AdrianPietrzak1998/FalconEye_ControlBoard_F1/PCB/Power_supply.kicad_sch

## KiCad design PCB/Power_supply.kicad_sch (2023-07-17)

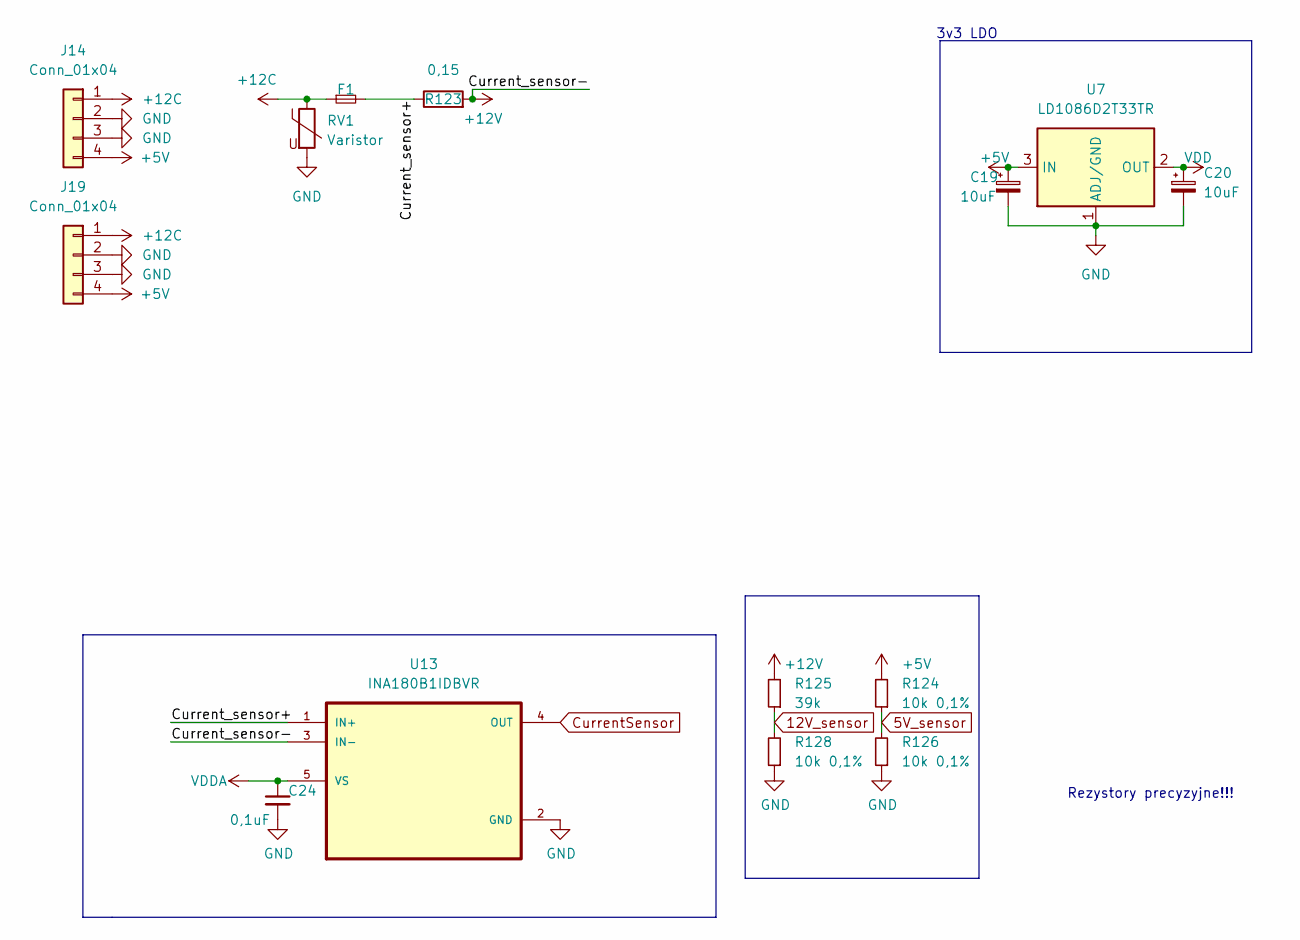
[picture p1: schematic Power_supply.kicad_sch]

Parts:
C19, C20: 10uF; C_0603_1608Metric; LCSC C19702
C24: 0,1uF; C_0603_1608Metric; LCSC C14663
F1: Fuse_Small; Fuseholder_Littelfuse_100_series_5x20mm
J14, J19: Conn_01x04; Molex_KK-254_AE-6410-04A_1x04_P2.54mm_Vertical
R123: 0,15; R_2512_6332Metric; LCSC C335237
R124, R126, R128: 10k 0,1%; R_0603_1608Metric; LCSC C374378
R125: 39k; R_0603_1608Metric; LCSC C23153
RV1: Varistor; RV_Disc_D7mm_W3.4mm_P5mm
U7: LD1086D2T33TR; TO-263-2; LCSC C7915
U13: INA180B1IDBVR; SOT95P280X145-5N; LCSC C122882

Connections:
5V_sensor: R124.1, R126.2
12V_sensor: R125.1, R128.2
+5V: C19.1, J14.4, J19.4, R124.2, U7.3 (IN)
+12C: F1.1, J14.1, J19.1, RV1.1
+12V: R123.2, R125.2, U13.3 (IN-)
CurrentSensor: U13.4 (OUT)
Current_sensor+: F1.2, R123.1, U13.1 (IN+)
GND: C19.2, C20.2, C24.2, J14.2, J14.3, J19.2, J19.3, R126.1, R128.1, RV1.2, U7.1 (ADJ/GND), U13.2 (GND)
VDD: C20.1, U7.2 (OUT)
VDDA: C24.1, U13.5 (VS)

Notes on the sheet:
3v3 LDO
Rezystory precyzyjne!!!
