AdrianPietrzak1998/FalconEye_ControlBoard_F1/PCB/USB_hub.kicad_sch

## KiCad design PCB/USB_hub.kicad_sch (2023-07-17)

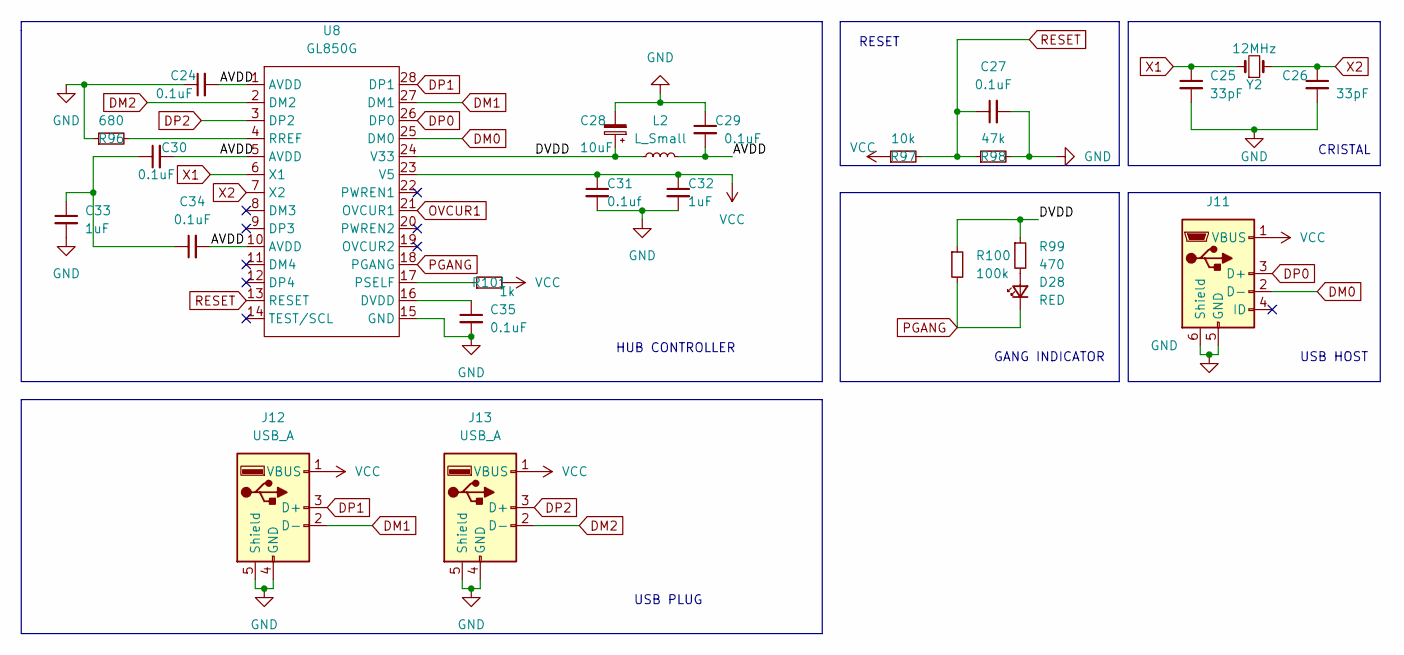
[picture p2: schematic USB_hub.kicad_sch]

Parts:
C24, C27, C29, C30, C34, C35: 0.1uF; C_0603_1608Metric
C25, C26: 33pF; C_0603_1608Metric
C28: 10uF; CP_Elec_4x4.5
C31: 0.1uf; C_0603_1608Metric
C32, C33: 1uF; C_0603_1608Metric
D28: RED; LED_0805_2012Metric
J11: USB_B_Mini; USB_Mini-B_Lumberg_2486_01_Horizontal
J12, J13: USB_A; USB_A_Stewart_SS-52100-001_Horizontal
L2: L_Small; L_0603_1608Metric
R96: 680; R_0603_1608Metric
R97: 10k; R_0603_1608Metric
R98: 47k; R_0603_1608Metric
R99: 470; R_0603_1608Metric
R100: 100k; R_0603_1608Metric
R101: 1k; R_0603_1608Metric
U8: GL850G; SSOP-28_3.9x9.9mm_P0.635mm
Y2: 12MHz; Crystal_SMD_3225-4Pin_3.2x2.5mm

Connections:
AVDD: C24.2, C29.2, C30.2, C34.2, L2.2, U8.1 (AVDD), U8.5 (AVDD), U8.10 (AVDD)
DM0: J11.2 (D-), U8.25 (DM0)
DM1: J12.2 (D-), U8.27 (DM1)
DM2: J13.2 (D-), U8.2 (DM2)
DP0: J11.3 (D+), U8.26 (DP0)
DP1: J12.3 (D+), U8.28 (DP1)
DP2: J13.3 (D+), U8.3 (DP2)
DVDD: C28.1, L2.1, R99.1, R100.1, U8.24 (V33)
GND: C24.1, C25.2, C26.2, C27.2, C28.2, C29.1, C31.2, C32.2, C33.2, C35.2, J11.5 (GND), J11.6 (Shield), J12.4 (GND), J12.5 (Shield), J13.4 (GND), J13.5 (Shield), R96.1, R98.2, U8.15 (GND)
unnamed: C30.1, C33.1, C34.1
unnamed: C35.1, U8.16 (DVDD)
unnamed: D28.2 (A), R99.2
unnamed: R96.2, U8.4 (RREF)
unnamed: R101.1, U8.17 (PSELF)
OVCUR1: U8.21 (OVCUR1)
PGANG: D28.1 (K), R100.2, U8.18 (PGANG)
RESET: C27.1, R97.2, R98.1, U8.13 (RESET)
VCC: C31.1, C32.1, J11.1 (VBUS), J12.1 (VBUS), J13.1 (VBUS), R97.1, R101.2, U8.23 (V5)
X1: C25.1, U8.6 (X1), Y2.1
X2: C26.1, U8.7 (X2), Y2.2

Notes on the sheet:
USB HOST
GANG INDICATOR
CRISTAL
RESET
USB PLUG
HUB CONTROLLER
