AdrianPietrzak1998/FalconEye_ControlBoard_F1/PCB/stm32_prototyp.kicad_sch

## KiCad design PCB/stm32_prototyp.kicad_sch (2023-07-17)

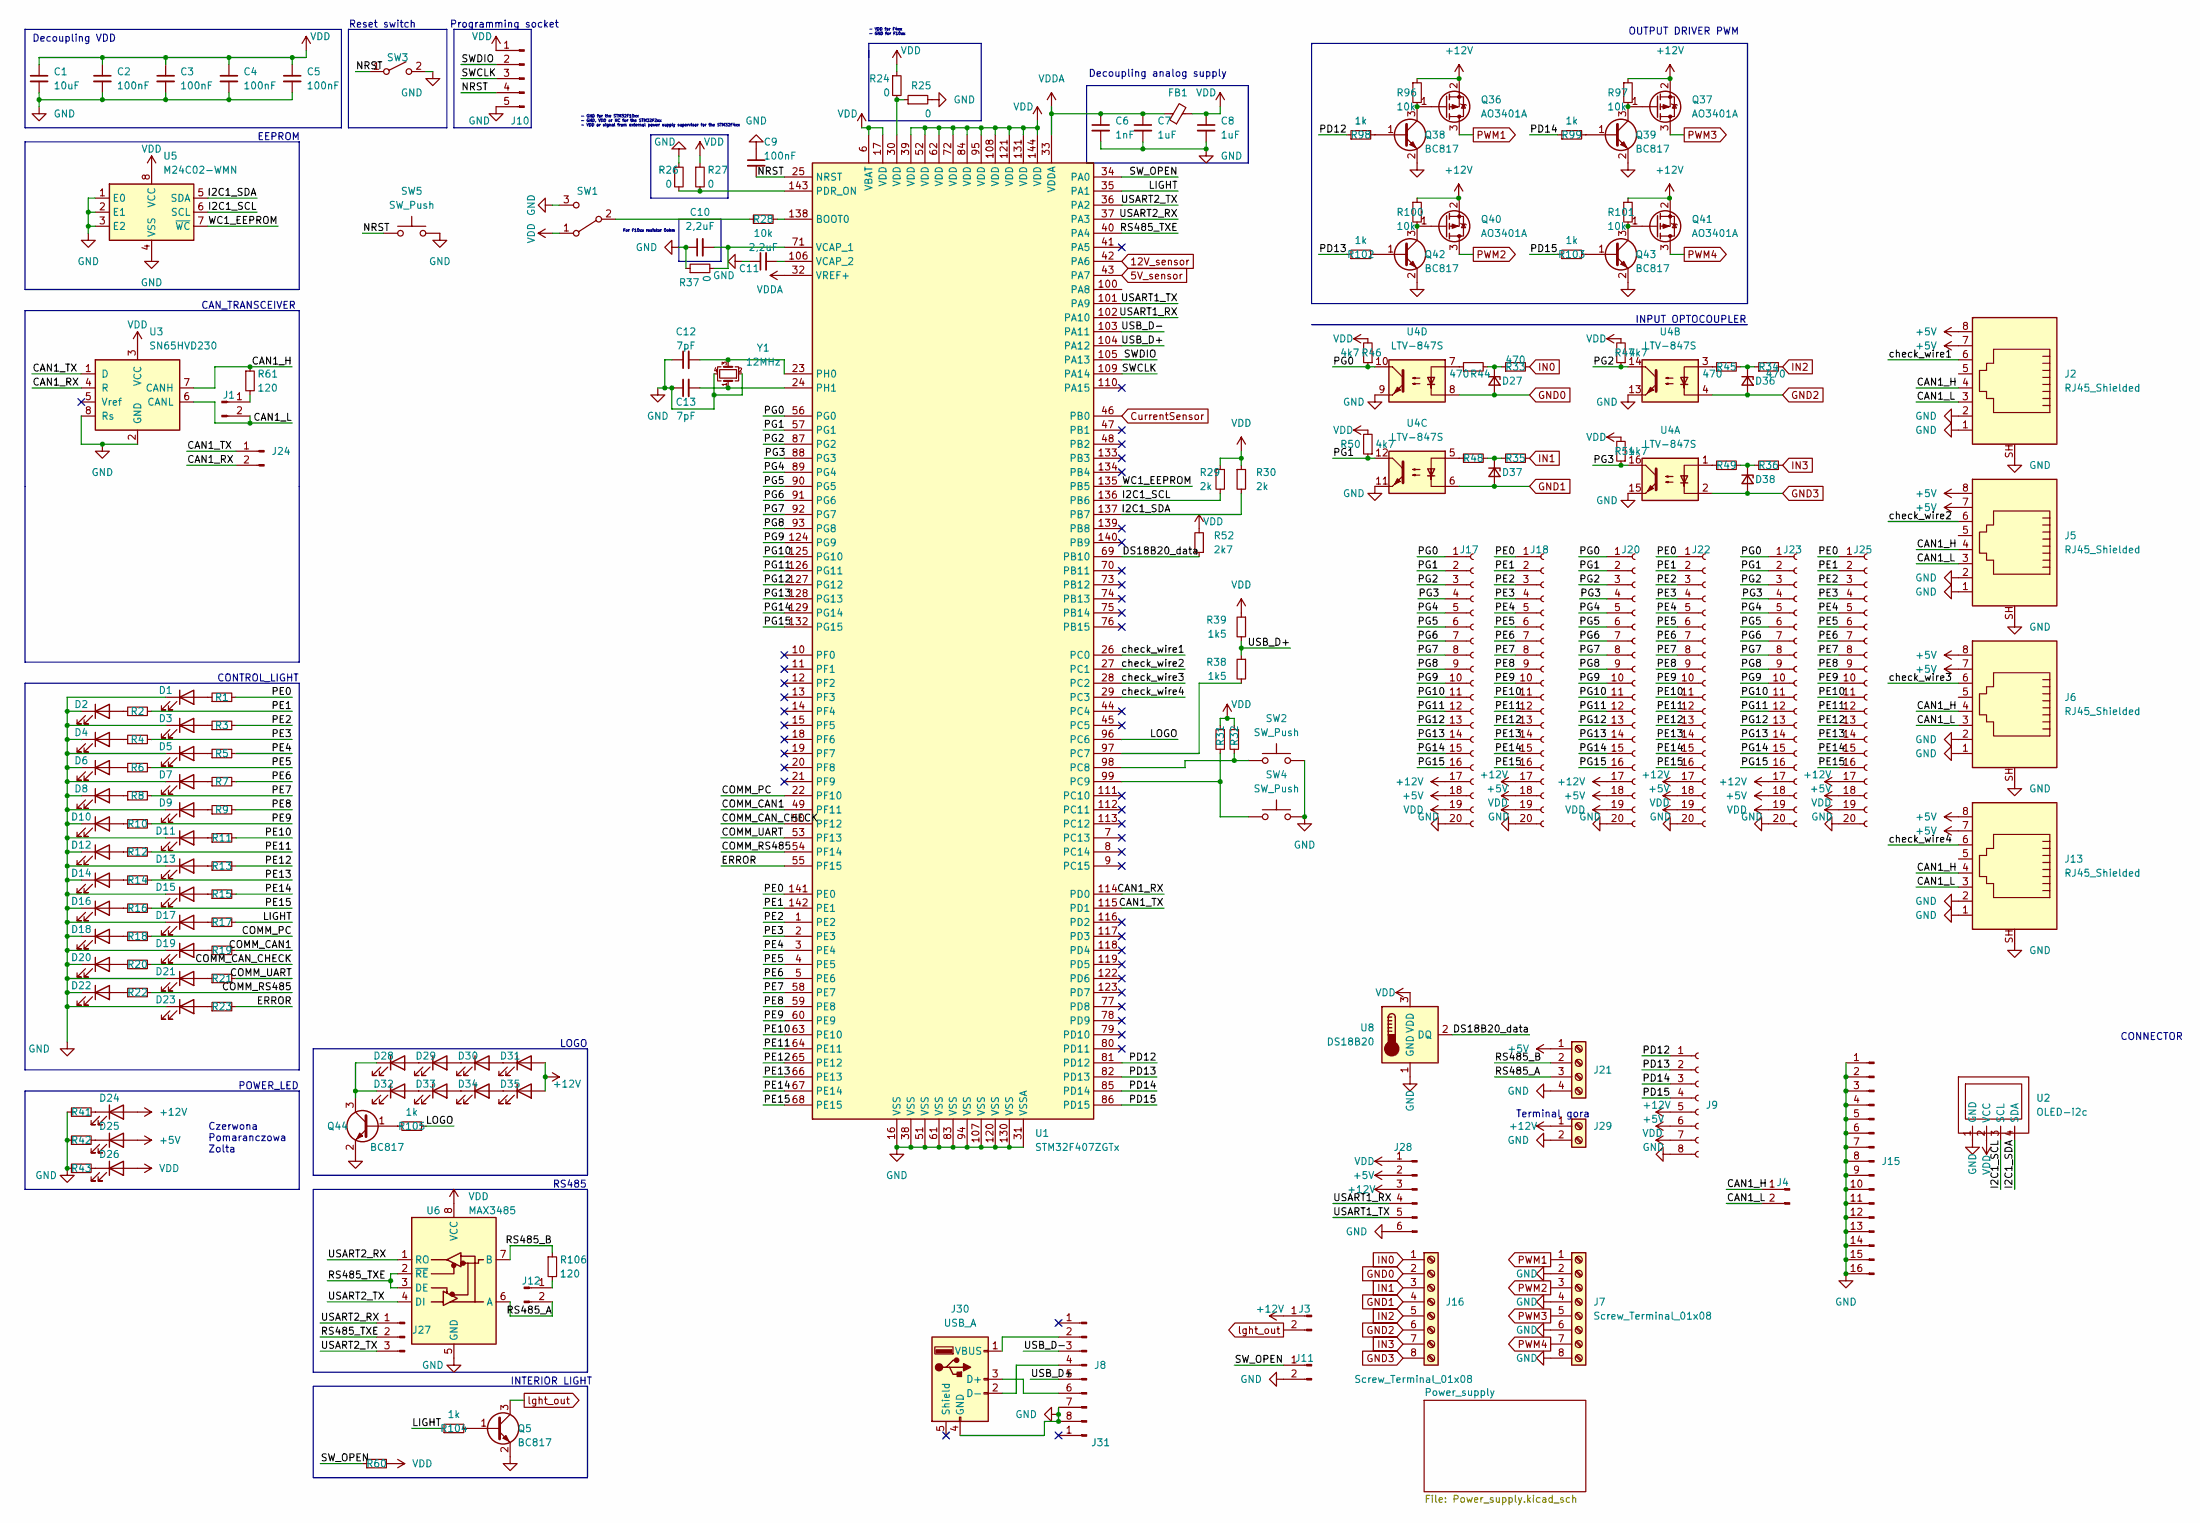
[picture p3: schematic stm32_prototyp.kicad_sch]

Parts:
C1: 10uF; C_1206_3216Metric; LCSC C13585
C2, C3, C4, C5, C9: 100nF; C_0603_1608Metric; LCSC C14663
C6: 1nF; C_0603_1608Metric; LCSC C1588
C7, C8: 1uF; C_0603_1608Metric; LCSC C15849
C10, C11: 2,2uF; C_0603_1608Metric; LCSC C23630
C12, C13: 7pF; C_0402_1005Metric; LCSC C260628
D1, D2, D3, D4, D5, D6, D7, D8, D9, D10, D11, D12, D13, D14, D15, D16, D18: Blue; LED_0603_1608Metric; LCSC C118339
D17: Green; LED_0603_1608Metric; LCSC C131282
D19, D23, D24: Red; LED_0603_1608Metric; LCSC C128052
D20, D25: Orange; LED_0603_1608Metric; LCSC C264452
D21, D22, D26: Yellow; LED_0603_1608Metric; LCSC C90109
D27, D36, D37, D38: D_Zener_Small; D_SOD-123; LCSC C86234
D28, D29, D30, D31, D32, D33, D34, D35: Green; LED_D5.0mm_Clear
FB1: FerriteBead_Small; L_0603_1608Metric; LCSC C76892
J1, J3, J4, J11, J12, J24: Conn_01x02_Male; PinHeader_1x02_P2.54mm_Vertical
J2, J5, J6, J13: RJ45_Shielded; RJ45_Molex_0855135013_Vertical; DigiKey 0855135013
J7, J16: Screw_Terminal_01x08; Altech_AK300_1x08_P5.00mm_45-Degree
J8: Conn_01x08_Male; PinHeader_2x04_P2.54mm_Vertical
J9: Conn_01x08_Female; PinHeader_2x04_P2.54mm_Vertical
J10: Conn_01x05_Male; PinHeader_1x05_P2.54mm_Vertical
J15: Conn_01x16_Male; PinHeader_2x08_P2.54mm_Vertical
J17, J18, J20, J22, J23, J25: Conn_01x20_Female; PinSocket_2x10_P2.54mm_Vertical
J21: Screw_Terminal_01x04; Altech_AK300_1x04_P5.00mm_45-Degree
J27: Conn_01x03_Male; PinHeader_1x03_P2.54mm_Vertical
J28: Conn_01x06_Male; IDC-Header_2x03_P2.54mm_Vertical
J29: Screw_Terminal_01x02; Altech_AK300_1x02_P5.00mm_45-Degree
J30: USB_A; USB_A_Molex_105057_Vertical
J31: Conn_01x01_Male; PinHeader_1x01_P2.54mm_Vertical
Q5, Q38, Q39, Q42, Q43, Q44: BC817; SOT-23; LCSC C475629
Q36, Q37, Q40, Q41: AO3401A; SOT-23; LCSC C15127
R1, R2, R3, R4, R5, R6, R7, R8, R9, R10, R11, R12, R13, R14, R15, R16, R18, R19, R20, R21, R22, R23: 100; R_0603_1608Metric; LCSC C22775
R17: 20; R_0603_1608Metric; LCSC C22950
R24, R25, R26, R27, R37: 0; R_0603_1608Metric; LCSC C21189
R28, R96, R97, R100, R101: 10k; R_0603_1608Metric; LCSC C25804
R29, R30: 2k; R_0603_1608Metric; LCSC C22975
R31, R32, R46, R47, R50, R51, R60: 4k7; R_0603_1608Metric; LCSC C23162
R33, R34, R35, R36, R41, R44, R45, R48, R49: 470; R_0603_1608Metric; LCSC C23179
R38, R39: 1k5; R_0603_1608Metric
R42: 150; R_0603_1608Metric; LCSC C22808
R43: 680; R_0603_1608Metric; LCSC C23228
R52: 2k7; R_0603_1608Metric; LCSC C13167
R61, R106: 120; R_0603_1608Metric; LCSC C22787
R98, R99, R102, R103, R104, R105: 1k; R_0603_1608Metric; LCSC C21190
SW1: SW_SPDT; PinHeader_1x03_P2.54mm_Vertical
SW2, SW4, SW5: SW_Push; SW_PUSH_6mm
SW3: SW_SPST; PinHeader_1x02_P2.54mm_Vertical
U1: STM32F407ZGTx; LQFP-144_20x20mm_P0.5mm
U2: OLED-i2c; 128x64OLED
U3: SN65HVD230; SOIC-8_3.9x4.9mm_P1.27mm; LCSC C12084
U4: LTV-847S; SMDIP-16_W9.53mm; LCSC C114599
U5: M24C02-WMN; SOIC-8_3.9x4.9mm_P1.27mm; LCSC C7562
U6: MAX3485; SOIC-8_3.9x4.9mm_P1.27mm; LCSC C668204
U8: DS18B20; TO-92_Inline; LCSC C9753
Y1: 12MHz; Crystal_SMD_7050-4Pin_7.0x5.0mm; LCSC C254255

Connections:
5V_sensor: U1.43 (PA7)
12V_sensor: U1.42 (PA6)
+5V: D25.2 (A), J2.7, J2.8, J5.7, J5.8, J6.7, J6.8, J9.6, J13.7, J13.8, J17.18, J18.18, J20.18, J21.1, J22.18, J23.18, J25.18, J28.2
+12V: D24.2 (A), D31.2 (A), D35.2 (A), J3.1, J9.5, J17.17, J18.17, J20.17, J22.17, J23.17, J25.17, J28.3, J29.1, Q36.2 (S), Q37.2 (S), Q40.2 (S), Q41.2 (S), R96.1, R97.1, R100.1, R101.1
CAN1_H: J2.4, J4.1, J5.4, J6.4, J13.4, R61.1, U3.7 (CANH)
CAN1_L: J1.2, J2.3, J4.2, J5.3, J6.3, J13.3, U3.6 (CANL)
CAN1_RX: J24.2, U1.114 (PD0), U3.4 (R)
CAN1_TX: J24.1, U1.115 (PD1), U3.1 (D)
COMM_CAN1: R19.2, U1.49 (PF11)
COMM_CAN_CHECK: R20.2, U1.50 (PF12)
COMM_PC: R18.2, U1.22 (PF10)
COMM_RS485: R22.2, U1.54 (PF14)
COMM_UART: R21.2, U1.53 (PF13)
CurrentSensor: U1.46 (PB0)
DS18B20_data: R52.1, U1.69 (PB10), U8.2 (DQ)
ERROR: R23.2, U1.55 (PF15)
GND: C1.2, C2.2, C3.2, C4.2, C5.2, C6.2, C7.2, C8.2, C9.1, C10.1, C11.1, C12.1, C13.1, D1.1 (K), D2.1 (K), D3.1 (K), D4.1 (K), D5.1 (K), D6.1 (K), D7.1 (K), D8.1 (K), D9.1 (K), D10.1 (K), D11.1 (K), D12.1 (K), D13.1 (K), D14.1 (K), D15.1 (K), D16.1 (K), D17.1 (K), D18.1 (K), D19.1 (K), D20.1 (K), D21.1 (K), D22.1 (K), D23.1 (K), J2.1, J2.2, J2.SH, J5.1, J5.2, J5.SH, J6.1, J6.2, J6.SH, J7.2, J7.4, J7.6, J7.8, J8.7, J8.8, J9.8, J10.5, J11.2, J13.1, J13.2, J13.SH, J15.1, J15.2, J15.3, J15.4, J15.5, J15.6, J15.7, J15.8, J15.9, J15.10, J15.11, J15.12, J15.13, J15.14, J15.15, J15.16, J17.20, J18.20, J20.20, J21.4, J22.20, J23.20, J25.20, J28.6, J29.2, J30.4 (GND), Q5.2 (E), Q38.2 (E), Q39.2 (E), Q42.2 (E), Q43.2 (E), Q44.2 (E), R25.2, R26.1, R37.1, R41.1, R42.1, R43.1, SW1.3 (C), SW2.1, SW3.2 (B), SW4.1, SW5.1, U1.16 (VSS), U1.31 (VSSA), U1.38 (VSS), U1.51 (VSS), U1.61 (VSS), U1.83 (VSS), U1.94 (VSS), U1.107 (VSS), U1.120 (VSS), U1.130 (VSS), U2.1 (GND), U3.2 (GND), U3.8 (Rs), U4.9, U4.11, U4.13, U4.15, U5.1 (E0), U5.2 (E1), U5.3 (E2), U5.4 (VSS), U6.5 (GND), U8.1 (GND), Y1.2, Y1.4
GND0: D27.2 (A), J16.2, U4.8
GND1: D37.2 (A), J16.4, U4.6
GND2: D36.2 (A), J16.6, U4.4
GND3: D38.2 (A), J16.8, U4.2
I2C1_SCL: R29.2, U1.136 (PB6), U2.3 (SCL), U5.6 (SCL)
I2C1_SDA: R30.2, U1.137 (PB7), U2.4 (SDA), U5.5 (SDA)
IN0: J16.1, R33.2
IN1: J16.3, R35.2
IN2: J16.5, R34.2
IN3: J16.7, R36.2
LIGHT: R17.2, R104.1, U1.35 (PA1)
LOGO: R105.1, U1.96 (PC6)
NRST: C9.2, J10.4, SW3.1 (A), SW5.2, U1.25 (NRST)
unnamed: C10.2, R37.2, U1.71 (VCAP_1)
unnamed: C11.2, U1.106 (VCAP_2)
unnamed: C12.2, U1.23 (PH0), Y1.3
unnamed: C13.2, U1.24 (PH1), Y1.1
unnamed: D1.2 (A), R1.1
unnamed: D2.2 (A), R2.1
unnamed: D3.2 (A), R3.1
unnamed: D4.2 (A), R4.1
unnamed: D5.2 (A), R5.1
unnamed: D6.2 (A), R6.1
unnamed: D7.2 (A), R7.1
unnamed: D8.2 (A), R8.1
unnamed: D9.2 (A), R9.1
unnamed: D10.2 (A), R10.1
unnamed: D11.2 (A), R11.1
unnamed: D12.2 (A), R12.1
unnamed: D13.2 (A), R13.1
unnamed: D14.2 (A), R14.1
unnamed: D15.2 (A), R15.1
unnamed: D16.2 (A), R16.1
unnamed: D17.2 (A), R17.1
unnamed: D18.2 (A), R18.1
unnamed: D19.2 (A), R19.1
unnamed: D20.2 (A), R20.1
unnamed: D21.2 (A), R21.1
unnamed: D22.2 (A), R22.1
unnamed: D23.2 (A), R23.1
unnamed: D24.1 (K), R41.2
unnamed: D25.1 (K), R42.2
unnamed: D26.1 (K), R43.2
unnamed: D27.1 (K), R33.1, R44.2
unnamed: D28.1 (K), D32.1 (K), Q44.3 (C)
unnamed: D28.2 (A), D29.1 (K)
unnamed: D29.2 (A), D30.1 (K)
unnamed: D30.2 (A), D31.1 (K)
unnamed: D32.2 (A), D33.1 (K)
unnamed: D33.2 (A), D34.1 (K)
unnamed: D34.2 (A), D35.1 (K)
unnamed: D36.1 (K), R34.1, R45.2
unnamed: D37.1 (K), R35.1, R48.2
unnamed: D38.1 (K), R36.1, R49.2
unnamed: J1.1, R61.2
unnamed: J12.1, R106.2
unnamed: J8.2, J30.1 (VBUS)
unnamed: J8.4, J30.2 (D-)
unnamed: J8.6, J30.3 (D+)
unnamed: Q5.1 (B), R104.2
unnamed: Q36.1 (G), Q38.3 (C), R96.2
unnamed: Q37.1 (G), Q39.3 (C), R97.2
unnamed: Q38.1 (B), R98.2
unnamed: Q39.1 (B), R99.2
unnamed: Q40.1 (G), Q42.3 (C), R100.2
unnamed: Q41.1 (G), Q43.3 (C), R101.2
unnamed: Q42.1 (B), R102.2
unnamed: Q43.1 (B), R103.2
unnamed: Q44.1 (B), R105.2
unnamed: R24.2, R25.1, U1.30 (VDD)
unnamed: R26.2, R27.2, U1.143 (PDR_ON)
unnamed: R28.1, SW1.2 (B)
unnamed: R28.2, U1.138 (BOOT0)
unnamed: R31.2, SW4.2, U1.99 (PC9)
unnamed: R32.2, SW2.2, U1.98 (PC8)
unnamed: R38.2, U1.97 (PC7)
unnamed: R44.1, U4.7
unnamed: R45.1, U4.3
unnamed: R48.1, U4.5
unnamed: R49.1, U4.1
PD12: J9.1, R98.1, U1.81 (PD12)
PD13: J9.2, R102.1, U1.82 (PD13)
PD14: J9.3, R99.1, U1.85 (PD14)
PD15: J9.4, R103.1, U1.86 (PD15)
PE0: J18.1, J22.1, J25.1, R1.2, U1.141 (PE0)
PE1: J18.2, J22.2, J25.2, R2.2, U1.142 (PE1)
PE2: J18.3, J22.3, J25.3, R3.2, U1.1 (PE2)
PE3: J18.4, J22.4, J25.4, R4.2, U1.2 (PE3)
PE4: J18.5, J22.5, J25.5, R5.2, U1.3 (PE4)
PE5: J18.6, J22.6, J25.6, R6.2, U1.4 (PE5)
PE6: J18.7, J22.7, J25.7, R7.2, U1.5 (PE6)
PE7: J18.8, J22.8, J25.8, R8.2, U1.58 (PE7)
PE8: J18.9, J22.9, J25.9, R9.2, U1.59 (PE8)
PE9: J18.10, J22.10, J25.10, R10.2, U1.60 (PE9)
PE10: J18.11, J22.11, J25.11, R11.2, U1.63 (PE10)
PE11: J18.12, J22.12, J25.12, R12.2, U1.64 (PE11)
PE12: J18.13, J22.13, J25.13, R13.2, U1.65 (PE12)
PE13: J18.14, J22.14, J25.14, R14.2, U1.66 (PE13)
PE14: J18.15, J22.15, J25.15, R15.2, U1.67 (PE14)
PE15: J18.16, J22.16, J25.16, R16.2, U1.68 (PE15)
PG0: J17.1, J20.1, J23.1, R46.1, U1.56 (PG0), U4.10
PG1: J17.2, J20.2, J23.2, R50.1, U1.57 (PG1), U4.12
PG2: J17.3, J20.3, J23.3, R47.1, U1.87 (PG2), U4.14
PG3: J17.4, J20.4, J23.4, R51.1, U1.88 (PG3), U4.16
PG4: J17.5, J20.5, J23.5, U1.89 (PG4)
PG5: J17.6, J20.6, J23.6, U1.90 (PG5)
PG6: J17.7, J20.7, J23.7, U1.91 (PG6)
PG7: J17.8, J20.8, J23.8, U1.92 (PG7)
PG8: J17.9, J20.9, J23.9, U1.93 (PG8)
PG9: J17.10, J20.10, J23.10, U1.124 (PG9)
PG10: J17.11, J20.11, J23.11, U1.125 (PG10)
PG11: J17.12, J20.12, J23.12, U1.126 (PG11)
PG12: J17.13, J20.13, J23.13, U1.127 (PG12)
PG13: J17.14, J20.14, J23.14, U1.128 (PG13)
PG14: J17.15, J20.15, J23.15, U1.129 (PG14)
PG15: J17.16, J20.16, J23.16, U1.132 (PG15)
PWM1: J7.1, Q36.3 (D)
PWM2: J7.3, Q40.3 (D)
PWM3: J7.5, Q37.3 (D)
PWM4: J7.7, Q41.3 (D)
RS485_A: J12.2, J21.3, U6.6 (A)
RS485_B: J21.2, R106.1, U6.7 (B)
RS485_TXE: J27.2, U1.40 (PA4), U6.2 (~RE), U6.3 (DE)
SWCLK: J10.3, U1.109 (PA14)
SWDIO: J10.2, U1.105 (PA13)
SW_OPEN: J11.1, R60.1, U1.34 (PA0)
USART1_RX: J28.4, U1.102 (PA10)
USART1_TX: J28.5, U1.101 (PA9)
USART2_RX: J27.1, U1.37 (PA3), U6.1 (RO)
USART2_TX: J27.3, U1.36 (PA2), U6.4 (DI)
USB_D+: J8.5, R38.1, R39.2, U1.104 (PA12)
USB_D-: J8.3, U1.103 (PA11)
VDD: C1.1, C2.1, C3.1, C4.1, C5.1, C8.1, D26.2 (A), FB1.2, J9.7, J10.1, J17.19, J18.19, J20.19, J22.19, J23.19, J25.19, J28.1, R24.1, R27.1, R29.1, R30.1, R31.1, R32.1, R39.1, R46.2, R47.2, R50.2, R51.2, R52.2, R60.2, SW1.1 (A), U1.6 (VBAT), U1.17 (VDD), U1.39 (VDD), U1.52 (VDD), U1.62 (VDD), U1.72 (VDD), U1.84 (VDD), U1.95 (VDD), U1.108 (VDD), U1.121 (VDD), U1.131 (VDD), U1.144 (VDD), U2.2 (VCC), U3.3 (VCC), U5.8 (VCC), U6.8 (VCC), U8.3 (VDD)
VDDA: C6.1, C7.1, FB1.1, U1.32 (VREF+), U1.33 (VDDA)
WC1_EEPROM: U1.135 (PB5), U5.7 (~WC)
check_wire1: J2.6, U1.26 (PC0)
check_wire2: J5.6, U1.27 (PC1)
check_wire3: J6.6, U1.28 (PC2)
check_wire4: J13.6, U1.29 (PC3)
lght_out: J3.2, Q5.3 (C)

Notes on the sheet:
Terminal gora
EEPROM
Decoupling VDD
Reset switch
INPUT OPTOCOUPLER
- GND for the STM32F10xx - GND, VDD or NC for the STM32F2xx - VDD or signal from external power supply supervisor for the STM32F4xx
CONNECTOR
CONTROL_LIGHT
INTERIOR LIGHT
Programming socket
Decoupling analog supply
LOGO
POWER_LED
Czerwona Pomaranczowa Zolta
For F10xx resistor 0ohm
CAN_TRANSCEIVER
- VDD for F4xx - GND for F10xx
OUTPUT DRIVER PWM
RS485
