AdrianPietrzak1998/FalconEye_ControlBoard_F1/FalconEye ControlBoard.ioc

Mcu.UserName=STM32F103ZETx
PA0-WKUP.GPIO_Label=SW_OPEN
PA0-WKUP.Signal=GPIO_Input
PA1.Signal=S_TIM5_CH2
PA10.Signal=USART1_RX
PA11.Signal=USB_DM
PA12.Signal=USB_DP
PA13.Signal=SYS_JTMS-SWDIO
PA14.Signal=SYS_JTCK-SWCLK
PA2.Signal=USART2_TX
PA3.Signal=USART2_RX
PA4.GPIO_Label=RS485_TXE
PA4.Signal=GPIO_Output
PA6.Signal=ADCx_IN6
PA7.Signal=ADCx_IN7
PA9.Signal=USART1_TX
PB0.Signal=ADCx_IN8
PB10.Signal=USART3_TX
PB5.GPIO_Label=WC_EEPROM
PB5.Signal=GPIO_Output
PB6.Signal=I2C1_SCL
PB7.Signal=I2C1_SDA
PC0.GPIO_Label=CHECK_WIRE_1
PC0.Signal=GPIO_Input
PC1.GPIO_Label=CHECK_WIRE_2
PC1.Signal=GPIO_Input
PC2.GPIO_Label=CHECK_WIRE_3
PC2.Signal=GPIO_Input
PC3.GPIO_Label=CHECK_WIRE_4
PC3.Signal=GPIO_Input
PC6.Signal=S_TIM3_CH1
PC8.GPIO_Label=BUTTON_DOWN
PC8.Signal=GPIO_Input
PC9.GPIO_Label=BUTTON_UP
PC9.Signal=GPIO_Input
PD12.Signal=S_TIM4_CH1
PD13.Signal=S_TIM4_CH2
PD14.Signal=S_TIM4_CH3
PD15.Signal=S_TIM4_CH4
PE0.Signal=GPIO_Output
PE1.Signal=GPIO_Output
PE10.Signal=GPIO_Output
PE11.Signal=GPIO_Output
PE12.Signal=GPIO_Output
PE13.Signal=GPIO_Output
PE14.Signal=GPIO_Output
PE15.Signal=GPIO_Output
PE2.Signal=GPIO_Output
PE3.Signal=GPIO_Output
PE4.Signal=GPIO_Output
PE5.Signal=GPIO_Output
PE6.Signal=GPIO_Output
PE7.Signal=GPIO_Output
PE8.Signal=GPIO_Output
PE9.Signal=GPIO_Output
PF10.GPIO_Label=COMM_PC_LED
PF10.Signal=GPIO_Output
PF11.GPIO_Label=COMM_CAN_LED
PF11.Signal=GPIO_Output
PF12.GPIO_Label=COMM_CAN_CHECK_LED
PF12.Signal=GPIO_Output
PF13.GPIO_Label=COMM_UART_LED
PF13.Signal=GPIO_Output
PF14.GPIO_Label=COMM_RS485_LED
PF14.Signal=GPIO_Output
PF15.GPIO_Label=ERROR_LED
PF15.Signal=GPIO_Output
PF2.Signal=GPIO_Input
PG0.Signal=GPIO_Input
PG1.Signal=GPIO_Input
PG10.Signal=GPIO_Input
PG11.Signal=GPIO_Input
PG12.Signal=GPIO_Input
PG13.Signal=GPIO_Input
PG14.Signal=GPIO_Input
PG15.Signal=GPIO_Input
PG2.Signal=GPIO_Input
PG3.Signal=GPIO_Input
PG4.Signal=GPIO_Input
PG5.Signal=GPIO_Input
PG6.Signal=GPIO_Input
PG7.Signal=GPIO_Input
PG8.Signal=GPIO_Input
PG9.Signal=GPIO_Input
