AdrianPietrzak1998/FalconEye_ControlBoard_F1/Core/Inc/main.h

#define __LOGO_LED_GET __HAL_TIM_GET_COMPARE(&htim3, TIM_CHANNEL_1)
#define __LIGHT_LED_GET __HAL_TIM_GET_COMPARE(&htim5, TIM_CHANNEL_2)
#define COMM_PC_LED_Pin GPIO_PIN_10
#define COMM_PC_LED_GPIO_Port GPIOF
#define CHECK_WIRE_1_Pin GPIO_PIN_0
#define CHECK_WIRE_1_GPIO_Port GPIOC
#define CHECK_WIRE_2_Pin GPIO_PIN_1
#define CHECK_WIRE_2_GPIO_Port GPIOC
#define CHECK_WIRE_3_Pin GPIO_PIN_2
#define CHECK_WIRE_3_GPIO_Port GPIOC
#define CHECK_WIRE_4_Pin GPIO_PIN_3
#define CHECK_WIRE_4_GPIO_Port GPIOC
#define SW_OPEN_Pin GPIO_PIN_0
#define SW_OPEN_GPIO_Port GPIOA
#define RS485_TXE_Pin GPIO_PIN_4
#define RS485_TXE_GPIO_Port GPIOA
#define COMM_CAN_LED_Pin GPIO_PIN_11
#define COMM_CAN_LED_GPIO_Port GPIOF
#define COMM_CAN_CHECK_LED_Pin GPIO_PIN_12
#define COMM_CAN_CHECK_LED_GPIO_Port GPIOF
#define COMM_UART_LED_Pin GPIO_PIN_13
#define COMM_UART_LED_GPIO_Port GPIOF
#define COMM_RS485_LED_Pin GPIO_PIN_14
#define COMM_RS485_LED_GPIO_Port GPIOF
#define ERROR_LED_Pin GPIO_PIN_15
#define ERROR_LED_GPIO_Port GPIOF
#define BUTTON_DOWN_Pin GPIO_PIN_8
#define BUTTON_DOWN_GPIO_Port GPIOC
#define BUTTON_UP_Pin GPIO_PIN_9
#define BUTTON_UP_GPIO_Port GPIOC
#define WC_EEPROM_Pin GPIO_PIN_5
#define WC_EEPROM_GPIO_Port GPIOB
#define ERROR_DS ErrorCode.DsError = 1
#define ERROR_OLED ErrorCode.OledError = 1
#define ERROR_EEPROM ErrorCode.EepromError = 1
