AdrianPietrzak1998/FalconEye_ControlBoard_F1/Core/Src/M24Cxx.c

/*
 * M24Cxx.c
 *
 *  Created on: Jun 15, 2023
 *      Author: Adrian
 */
#include "M24Cxx.h"
#include "main.h"



void m24cxxInit(m24cxx_t *m24, I2C_HandleTypeDef *i2c, uint8_t addr, uint16_t memsize, GPIO_TypeDef *WcPort, uint16_t WcPin)
{
	m24 -> addr    = addr<<1;
	m24 -> i2c     = i2c;
	m24 -> memsize = memsize;
	m24 -> WcPort  = WcPort;
	m24 -> WcPin   = WcPin;
	HAL_GPIO_WritePin(m24->WcPort, m24->WcPin, SET);
}

HAL_StatusTypeDef m24cxxRead8Bit(m24cxx_t *m24, uint8_t DataAddr, uint8_t *Data)
{
	int32_t i = 0;
	while((m24->i2c)->hdmarx->State != HAL_DMA_STATE_READY && i<=200000)
	{
		i++;
	}
	if((m24->i2c)->hdmarx->State == HAL_DMA_STATE_READY)
	{
	HAL_I2C_Mem_Read_DMA(m24 ->i2c, m24 -> addr, DataAddr, 1, Data, 1);
	return HAL_OK;
	}
	else
	{
		ERROR_EEPROM;
		return HAL_ERROR;
	}
}

void m24cxxRead8BitWoDma(m24cxx_t *m24, uint8_t DataAddr, uint8_t *Data)
{
	HAL_I2C_Mem_Read(m24 ->i2c, m24 -> addr, DataAddr, 1, Data, 1, 500);
}

HAL_StatusTypeDef m24cxxWrite8Bit(m24cxx_t *m24, uint8_t DataAddr, uint8_t *Data)
{
	HAL_GPIO_WritePin(m24->WcPort, m24->WcPin, RESET);
	m24 -> WcIsZero = 1;
	int32_t i = 0;
	while((m24->i2c)->hdmatx->State != HAL_DMA_STATE_READY && i<=200000)
	{
		i++;
	}
	if((m24->i2c)->hdmatx->State == HAL_DMA_STATE_READY)
	{
	HAL_I2C_Mem_Write_DMA(m24 -> i2c, m24 -> addr, DataAddr, 1, Data, 1);
	m24 -> OldTickWriteEeprom = HAL_GetTick();
	return HAL_OK;
	}
	else
	{	ERROR_EEPROM;
		return HAL_ERROR;
	}
}

void m24cxxWrite8BitWoDma(m24cxx_t *m24, uint8_t DataAddr, uint8_t *Data)
{
	HAL_GPIO_WritePin(m24->WcPort, m24->WcPin, RESET);
	HAL_I2C_Mem_Write(m24 -> i2c, m24 -> addr, DataAddr, 1, Data, 1, 1000);
}

uint8_t m24cxxRead16Bit(m24cxx_t *m24, uint8_t DataAddr, uint16_t *Data)
{
	int32_t i = 0;
	while((m24->i2c)->hdmarx->State != HAL_DMA_STATE_READY && i<=200000)
	{
		i++;
	}
	if((m24->i2c)->hdmarx->State == HAL_DMA_STATE_READY)
	{
	HAL_I2C_Mem_Read_DMA(m24 ->i2c, m24 -> addr, DataAddr, 1, Data, 2);
	return HAL_OK;
	}
	else
	{
		return HAL_ERROR;
	}
}

uint8_t m24cxxWrite16Bit(m24cxx_t *m24, uint8_t DataAddr, uint16_t *Data)
{
	HAL_GPIO_WritePin(m24->WcPort, m24->WcPin, RESET);
	m24 -> WcIsZero = 1;
	int32_t i = 0;
	while((m24->i2c)->hdmatx->State != HAL_DMA_STATE_READY && i<=200000)
	{
		i++;
	}
	if((m24->i2c)->hdmatx->State == HAL_DMA_STATE_READY)
	{
	HAL_I2C_Mem_Write_DMA(m24 -> i2c, m24 -> addr, DataAddr, 1, Data, 2);
	return HAL_OK;
	}
	else
	{
		return HAL_ERROR;
	}
}

uint8_t m24cxxRead32Bit(m24cxx_t *m24, uint8_t DataAddr, uint32_t *Data)
{
	int32_t i = 0;
	while((m24->i2c)->hdmarx->State != HAL_DMA_STATE_READY && i<=200000)
	{
		i++;
	}
	if((m24->i2c)->hdmarx->State == HAL_DMA_STATE_READY)
	{
	HAL_I2C_Mem_Read_DMA(m24 ->i2c, m24 -> addr, DataAddr, 1, Data, 4);
	return HAL_OK;
	}
	else
	{
		return HAL_ERROR;
	}
}

uint8_t m24cxxWrite32Bit(m24cxx_t *m24, uint8_t DataAddr, uint32_t *Data)
{
	HAL_GPIO_WritePin(m24->WcPort, m24->WcPin, RESET);
	m24 -> WcIsZero = 1;
	int32_t i = 0;
	while((m24->i2c)->hdmatx->State != HAL_DMA_STATE_READY && i<=200000)
	{
		i++;
	}
	if((m24->i2c)->hdmatx->State == HAL_DMA_STATE_READY)
	{
	HAL_I2C_Mem_Write_DMA(m24 -> i2c, m24 -> addr, DataAddr, 1, Data, 4);
	return HAL_OK;
	}
	else
	{
		return HAL_ERROR;
	}
}

uint8_t m24cxxFullRead(m24cxx_t *m24, uint8_t *Data)
{
	int32_t i = 0;
	while((m24->i2c)->hdmarx->State != HAL_DMA_STATE_READY && i<=200000)
	{
		i++;
	}
	if((m24->i2c)->hdmarx->State == HAL_DMA_STATE_READY)
	{
	HAL_I2C_Mem_Read_DMA(m24 -> i2c, m24 -> addr, 0x00, 1, Data, m24 -> memsize);
	return HAL_OK;
	}
	else
	{
		return HAL_ERROR;
	}
}

void m24cxxFullReadWoDma(m24cxx_t *m24, uint8_t *Data)
{
	HAL_I2C_Mem_Read(m24 -> i2c, m24 -> addr, 0x00, 1, Data, m24 -> memsize, 1000);
}

void m24cxxFullWrite(m24cxx_t *m24, uint8_t *Data)
{
	HAL_GPIO_WritePin(m24->WcPort, m24->WcPin, RESET);
	for(uint16_t memAddr = 0; memAddr<m24 -> memsize; memAddr = memAddr + 16)
	{
		HAL_Delay(3);
		HAL_I2C_Mem_Write(m24 -> i2c, m24 -> addr, memAddr, 1, Data + memAddr, 16, 50);

	}
	HAL_GPIO_WritePin(m24->WcPort, m24->WcPin, SET);
}

void m24cxxEarese(m24cxx_t *m24)
{
	HAL_GPIO_WritePin(m24->WcPort, m24->WcPin, RESET);
	uint8_t Fill[16] = {0xff,0xff,0xff,0xff,0xff,0xff,0xff,0xff,0xff,0xff,0xff,0xff,0xff,0xff,0xff,0xff};
	for(uint16_t memAddr = 0; memAddr<m24 -> memsize; memAddr = memAddr + 8)
		{
		HAL_Delay(3);
		HAL_I2C_Mem_Write(m24 -> i2c, m24 -> addr, memAddr, 1, Fill, 8, 100);
		}
	HAL_GPIO_WritePin(m24->WcPort, m24->WcPin, SET);
}

void m24cxxWcSetIt(m24cxx_t *m24, I2C_HandleTypeDef *hi2c)
{
	if(hi2c->Instance == m24->i2c->Instance && m24->WcIsZero == 1)
	{
		HAL_GPIO_WritePin(m24->WcPort, m24->WcPin, SET);
		m24->WcIsZero = 0;
	}
}
