AdrianPietrzak1998/FalconEye_ControlBoard_F1/(commit log)

2023-06-27 Menu hard fault error fixed
    [FalconEye ControlBoard.ioc, main.c, menu.c, menu.h, parser_complex.c, parser_complex.h]
2023-06-29 I2C bus DMA
2023-06-30 Add ADC and double buffering with DMA
2023-07-05 Added status led blink library and pwm menu
2023-07-17 USB after reset - fixed
    [main.c]
2023-07-17 PCB file
    [BOM.xlsx, Power_supply.kicad_sch, Sample-BOM_JLCSMT.xlsx, USB_hub.kicad_sch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]
2023-08-03 Added watchdog timer
